GodOfStrategy/Custom-PSU/CAD/Bottom/Custom_PSU_2(bottom[2][).step

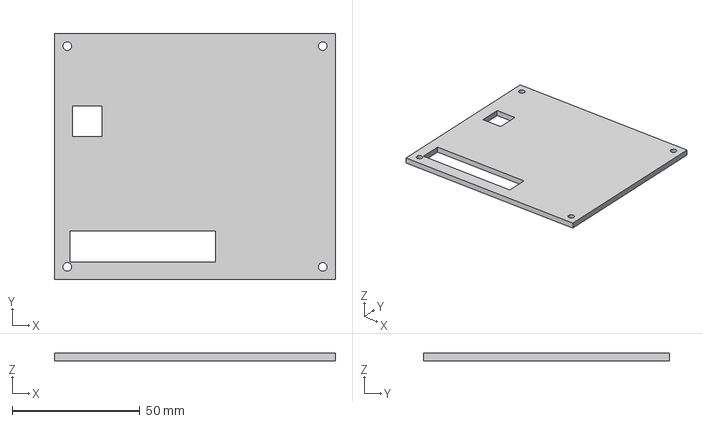
[picture p1: CAD file, 2026-11-05]
CAD/Bottom/Custom_PSU_2(bottom[2][).step
110.0 x 96.4 x 3.00 mm
