GodOfStrategy/Custom-PSU/CAD/CAD bottom/PSU[2](Bottom).stl

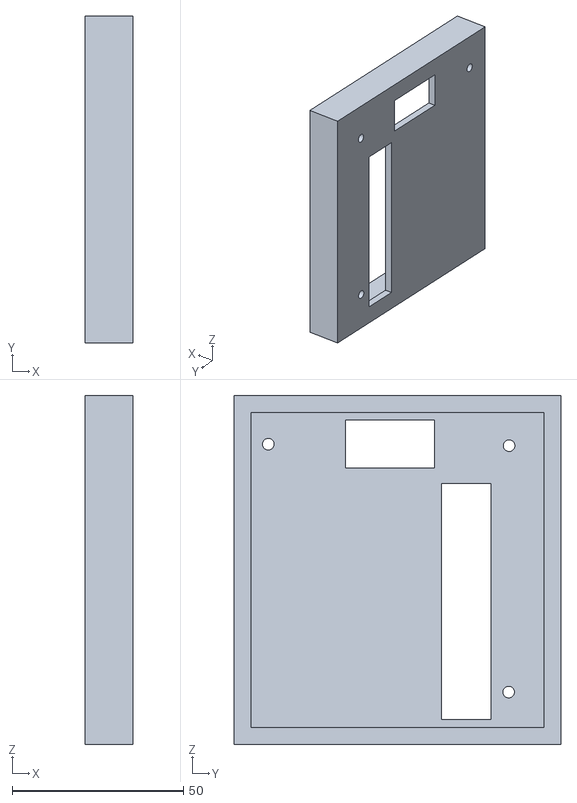
[picture p2: CAD file, 2026-11-05]
CAD/CAD bottom/PSU[2](Bottom).stl
14.0 x 95.4 x 101.9
