GodOfStrategy/Custom-PSU/CAD/Bottom/Custom_PSU_2(bottom[1]).step

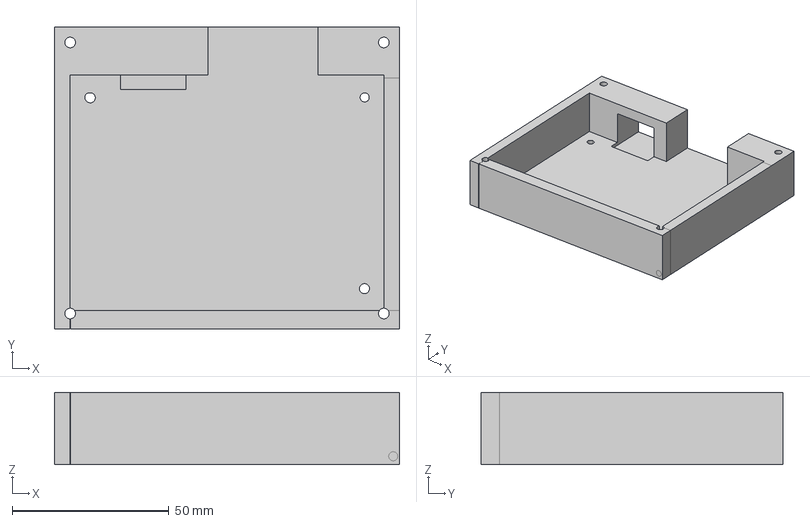
[picture p3: CAD file, 2026-11-05]
CAD/Bottom/Custom_PSU_2(bottom[1]).step
110.0 x 96.4 x 23.0 mm
