GodOfStrategy/Custom-PSU/CAD/Top/Custom_PSU_2(top[2]).step

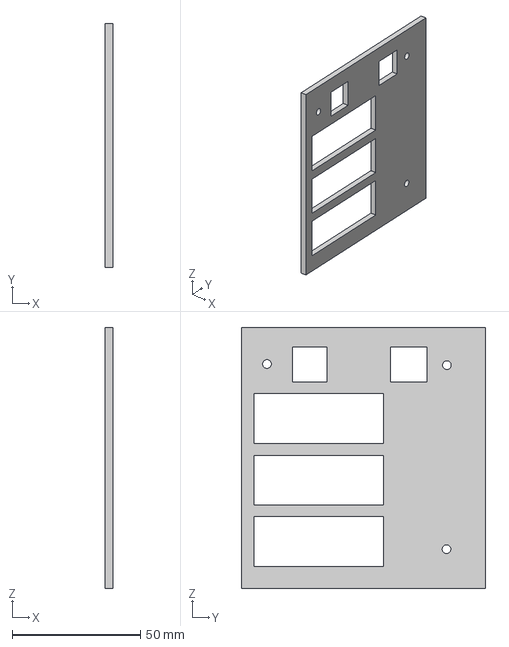
[picture p4: CAD file, 2026-11-05]
CAD/Top/Custom_PSU_2(top[2]).step
3.00 x 95.4 x 101.9 mm
