GodOfStrategy/Custom-PSU/(list of files, cad)

Other CAD files:
CAD/Custom_PSU_2(assembled).step
CAD/Custom_PSU_2(Assembled(1)).step
CAD/Top/Custom_PSU_2(top[1]).step
Custom_PSU_2(bottom[2]).step
Custom_PSU_2(top[2]).step
CAD/Bottom/Custom_PSU_2(bottom[1]l).step
CAD/PSU(Assembled[1]).f3z
