GodOfStrategy/Custom-PSU/Production/PCB 2/Custom_PSU_2.kicad_pcb

## KiCad design Production/PCB 2/Custom_PSU_2.kicad_pcb (2026-11-05)

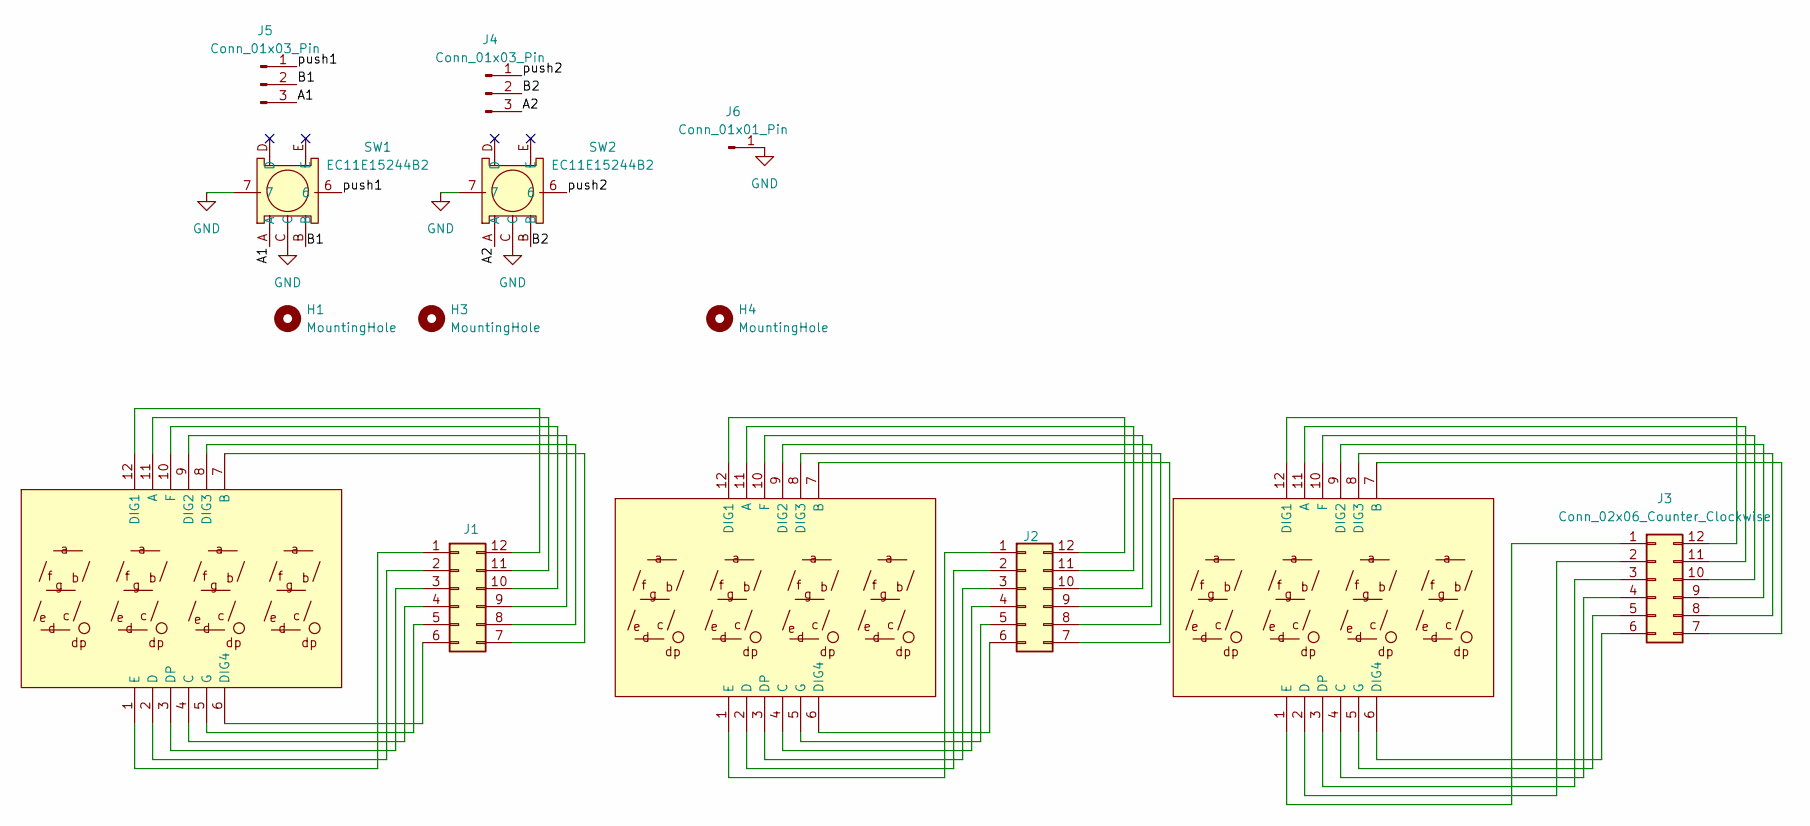
[picture p5: schematic Custom_PSU_2.kicad_sch]

Parts:
H1, H3, H4: MountingHole; MountingHole_3.2mm_M3_ISO7380
J1, J2, J3: Conn_02x06_Counter_Clockwise; PinHeader_2x06_P2.54mm_Vertical
J4, J5: Conn_01x03_Pin; PinHeader_1x03_P2.54mm_Vertical
J6: Conn_01x01_Pin; PinHeader_1x01_P2.54mm_Vertical
LED1, LED2, LED3: SR420561N; LED-SEG-TH_12P-L50.3-W19.0-P2.54-S15.24-BL; MPN SR420561N; LCSC Part C109200
SW1, SW2: EC11E15244B2; SW-TH_EC11XXXXXXXX; MPN EC11E15244B2; LCSC Part C470754

Connections:
/A1: J5.3, SW1.A
/A2: J4.3, SW2.A
/B1: J5.2, SW1.B
/B2: J4.2, SW2.B
/push1: J5.1, SW1.6
/push2: J4.1, SW2.6
GND: J6.1, SW1.7, SW1.C, SW2.7, SW2.C
unnamed: J1.1, LED1.1 (E)
unnamed: J1.2, LED1.2 (D)
unnamed: J1.3, LED1.3 (DP)
unnamed: J1.4, LED1.4 (C)
unnamed: J1.5, LED1.5 (G)
unnamed: J1.6, LED1.6 (DIG4)
unnamed: J1.7, LED1.7 (B)
unnamed: J1.8, LED1.8 (DIG3)
unnamed: J1.9, LED1.9 (DIG2)
unnamed: J1.10, LED1.10 (F)
unnamed: J1.11, LED1.11 (A)
unnamed: J1.12, LED1.12 (DIG1)
unnamed: J2.1, LED2.1 (E)
unnamed: J2.2, LED2.2 (D)
unnamed: J2.3, LED2.3 (DP)
unnamed: J2.4, LED2.4 (C)
unnamed: J2.5, LED2.5 (G)
unnamed: J2.6, LED2.6 (DIG4)
unnamed: J2.7, LED2.7 (B)
unnamed: J2.8, LED2.8 (DIG3)
unnamed: J2.9, LED2.9 (DIG2)
unnamed: J2.10, LED2.10 (F)
unnamed: J2.11, LED2.11 (A)
unnamed: J2.12, LED2.12 (DIG1)
unnamed: J3.1, LED3.1 (E)
unnamed: J3.2, LED3.2 (D)
unnamed: J3.3, LED3.3 (DP)
unnamed: J3.4, LED3.4 (C)
unnamed: J3.5, LED3.5 (G)
unnamed: J3.6, LED3.6 (DIG4)
unnamed: J3.7, LED3.7 (B)
unnamed: J3.8, LED3.8 (DIG3)
unnamed: J3.9, LED3.9 (DIG2)
unnamed: J3.10, LED3.10 (F)
unnamed: J3.11, LED3.11 (A)
unnamed: J3.12, LED3.12 (DIG1)

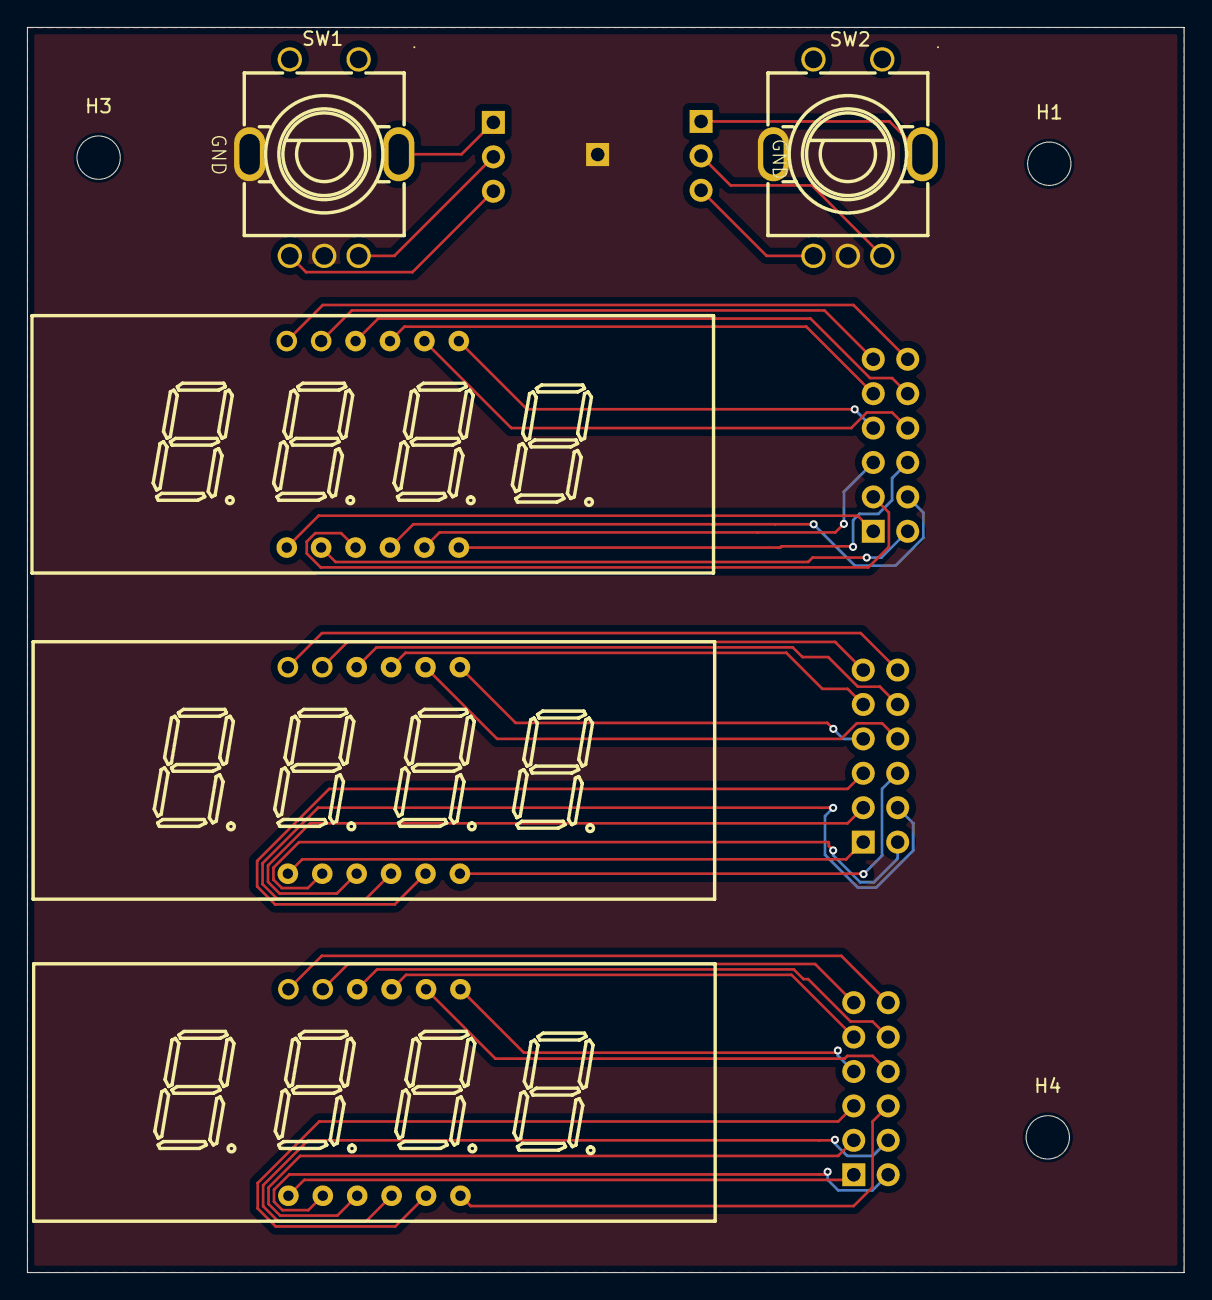
[picture p6: board Custom_PSU_2.kicad_pcb from above]

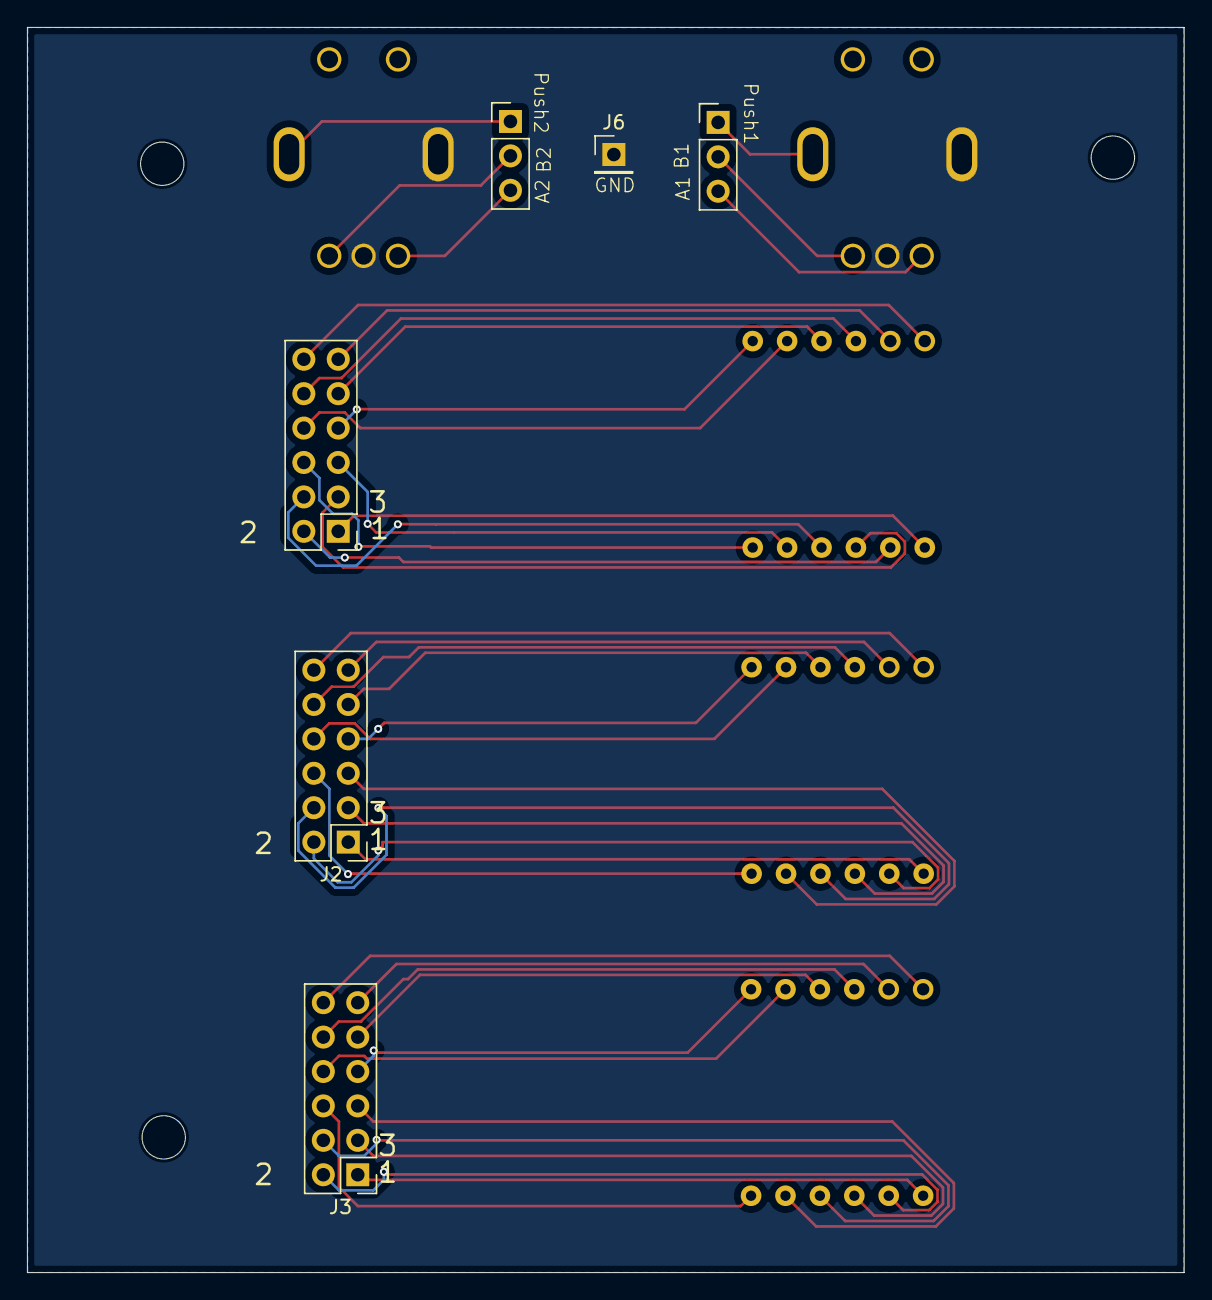
[picture p7: board Custom_PSU_2.kicad_pcb from below]

Board: 2 copper layers, 85.4 x 91.9 mm, 14 parts (6 on the bottom side), 43 nets.
