GodOfStrategy/Custom-PSU/(commit log)

2026-10-05 Added CAD files and project updates
    [PSU[1](Bottom).stl, PSU[2](Bottom).stl]
2026-11-05 Added the CAD files
2026-11-05 Organize CAD files into Top and Bottom folders
2026-11-05 Add reorganized CAD files
2026-11-05 Add CAD files
